ganqrr-crypto/STM32_devboard_STM32F411RET/CAD/STM32_Board.step

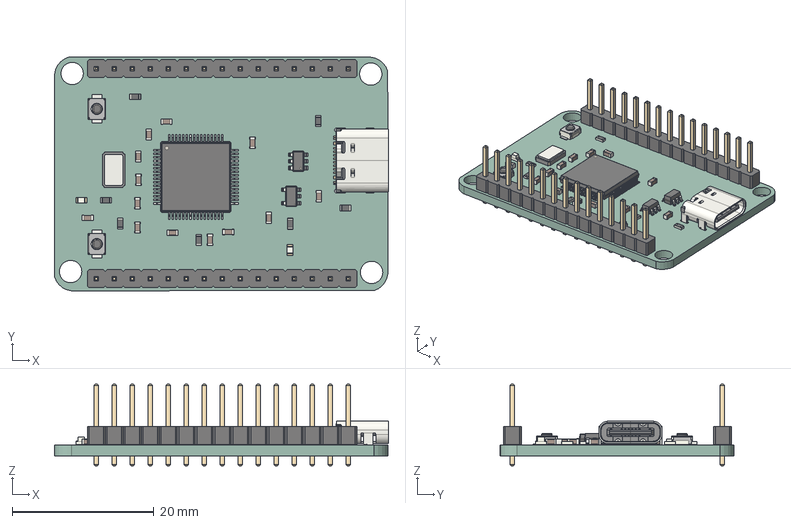
[picture p1: CAD file, 2026-11-06]
CAD/STM32_Board.step
47.2 x 33.0 x 11.5 mm
R_0603_1608Metric x 7
C_0603_1608Metric x 13
SOT-23-6
PinHeader_1x15_P254mm_Vertical x 2
LED_0603_1608Metric x 2
SW_SPST_B3U-1000P x 2
Crystal_SMD_Abracon_ABM3B-4Pin_5.0x3.2mm
SOT-23-5
LQFP-64_10x10mm_P0.5mm
USB_C_Receptacle_16P_TopMnt_Horizontal_GCT_USB4105-xx-A
STM1B8D_PCB
