ganqrr-crypto/STM32_devboard_STM32F411RET/PCB/STM32_Board.kicad_pcb

## KiCad design PCB/STM32_Board.kicad_pcb (2026-11-06)

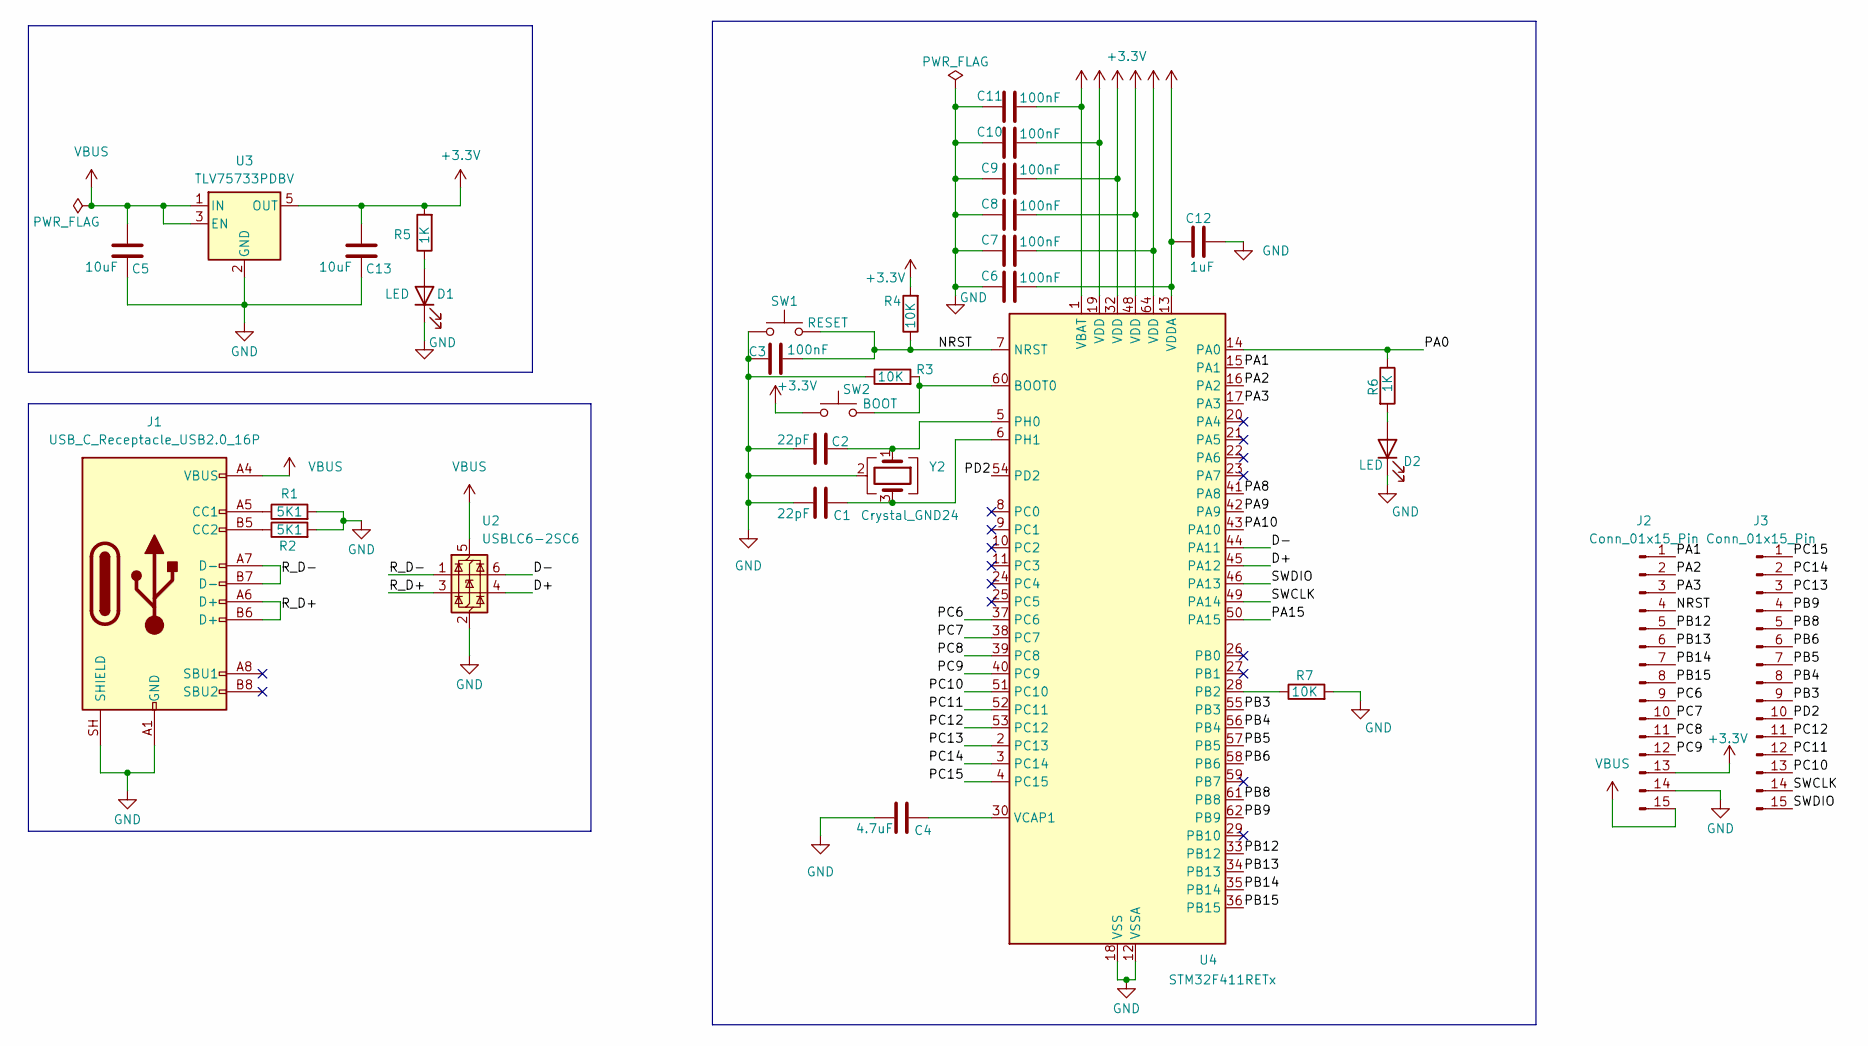
[picture p2: schematic STM32_Board.kicad_sch]

Parts:
C1, C2: 22pF; C_0603_1608Metric_Pad1.08x0.95mm_HandSolder
C3, C6, C7, C8, C9, C10, C11: 100nF; C_0603_1608Metric_Pad1.08x0.95mm_HandSolder
C4: 4.7uF; C_0603_1608Metric_Pad1.08x0.95mm_HandSolder
C5, C13: 10uF; C_0603_1608Metric_Pad1.08x0.95mm_HandSolder
C12: 1uF; C_0603_1608Metric_Pad1.08x0.95mm_HandSolder
D1, D2: LED; LED_0603_1608Metric_Pad1.05x0.95mm_HandSolder
J1: USB_C_Receptacle_USB2.0_16P; USB_C_Receptacle_GCT_USB4105-xx-A_16P_TopMnt_Horizontal
J2, J3: Conn_01x15_Pin; PinHeader_1x15_P2.54mm_Vertical
R1, R2: 5K1; R_0603_1608Metric_Pad0.98x0.95mm_HandSolder
R3, R4, R7: 10K; R_0603_1608Metric_Pad0.98x0.95mm_HandSolder
R5, R6: 1K; R_0603_1608Metric_Pad0.98x0.95mm_HandSolder
SW1: RESET; SW_SPST_B3U-1000P
SW2: BOOT; SW_SPST_B3U-1000P
U2: USBLC6-2SC6; SOT-23-6
U3: TLV75733PDBV; SOT-23-5
U4: STM32F411RETx; LQFP-64_10x10mm_P0.5mm
Y2: Crystal_GND24; Crystal_SMD_Abracon_ABM3B-4Pin_5.0x3.2mm

Connections:
+3.3V: C6.2, C7.2, C8.2, C9.2, C10.2, C11.2, C12.2, C13.1, J2.13, R4.2, R5.2, SW2.1, U3.5 (OUT), U4.1 (VBAT), U4.13 (VDDA), U4.19 (VDD), U4.32 (VDD), U4.48 (VDD), U4.64 (VDD); also elsewhere on the board
/D+: U2.4 (I/O2), U4.45 (PA12)
/D-: U2.6 (I/O1), U4.44 (PA11)
/NRST: C3.2, J2.4, R4.1, SW1.2, U4.7 (NRST); also elsewhere on the board
/PA0: R6.1, U4.14 (PA0)
/PA1: J2.1, U4.15 (PA1)
/PA2: J2.2, U4.16 (PA2)
/PA3: J2.3, U4.17 (PA3)
/PA8: U4.41 (PA8)
/PA9: U4.42 (PA9)
/PA10: U4.43 (PA10)
/PA15: U4.50 (PA15)
/PB3: J3.9, U4.55 (PB3)
/PB4: J3.8, U4.56 (PB4)
/PB5: J3.7, U4.57 (PB5)
/PB6: J3.6, U4.58 (PB6)
/PB8: J3.5, U4.61 (PB8)
/PB9: J3.4, U4.62 (PB9)
/PB12: J2.5, U4.33 (PB12)
/PB13: J2.6, U4.34 (PB13)
/PB14: J2.7, U4.35 (PB14)
/PB15: J2.8, U4.36 (PB15)
/PC6: J2.9, U4.37 (PC6)
/PC7: J2.10, U4.38 (PC7)
/PC8: J2.11, U4.39 (PC8)
/PC9: J2.12, U4.40 (PC9)
/PC10: J3.13, U4.51 (PC10)
/PC11: J3.12, U4.52 (PC11)
/PC12: J3.11, U4.53 (PC12)
/PC13: J3.3, U4.2 (PC13)
/PC14: J3.2, U4.3 (PC14)
/PC15: J3.1, U4.4 (PC15)
/PD2: J3.10, U4.54 (PD2)
/R_D+: J1.A6 (D+), J1.B6 (D+), U2.3 (I/O2)
/R_D-: J1.A7 (D-), J1.B7 (D-), U2.1 (I/O1)
/SWCLK: J3.14, U4.49 (PA14)
/SWDIO: J3.15, U4.46 (PA13)
GND: C1.1, C2.1, C3.1, C4.1, C5.2, C6.1, C7.1, C8.1, C9.1, C10.1, C11.1, C12.1, C13.2, D1.1 (K), D2.1 (K), J1.A1 (GND), J1.A12 (GND), J1.B1 (GND), J1.B12 (GND), J1.SH (SHIELD), J2.14, R1.2, R2.2, R3.1, R7.2, SW1.1, U2.2 (GND), U3.2 (GND), U4.12 (VSSA), U4.18 (VSS), U4.31 (VSS), U4.47 (VSS), U4.63 (VSS), Y2.2 (G), Y2.4 (G); also elsewhere on the board
unnamed: D1.2 (A), R5.1
unnamed: D2.2 (A), R6.2
unnamed: J1.A5 (CC1), R1.1
unnamed: J1.B5 (CC2), R2.1
unnamed 42: R3.2, SW2.2, U4.60 (BOOT0); also elsewhere on the board
unnamed: R7.1, U4.28 (PB2)
unnamed: C2.2, U4.5 (PH0), Y2.1
unnamed: C1.2, U4.6 (PH1), Y2.3
unnamed: C4.2, U4.30 (VCAP1)
VBUS: C5.1, J1.A4 (VBUS), J1.A9 (VBUS), J1.B4 (VBUS), J1.B9 (VBUS), J2.15, U2.5 (VBUS), U3.1 (IN), U3.3 (EN)

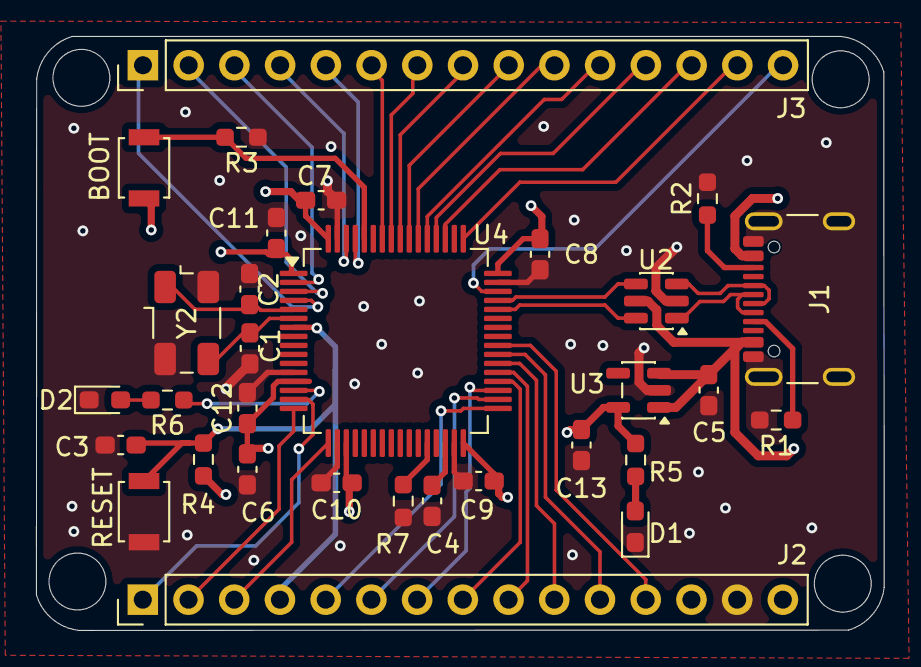
[picture p3: board STM32_Board.kicad_pcb from above]

Board: 4 copper layers, 47.1 x 33.0 mm, 31 parts (0 on the bottom side), 44 nets.

Other parts of the board:
BOOT: BOOT; SW_SPST_B3U-1000P
RESET: RESET; SW_SPST_B3U-1000P

Their connections:
+3.3V: BOOT.1; also elsewhere on the board
/NRST: RESET.2; also elsewhere on the board
GND: RESET.1; also elsewhere on the board
unnamed 42: BOOT.2; also elsewhere on the board
