ganqrr-crypto/STM32_devboard_STM32F411RET/JOURNAL.md

---
title: "STM32 Board"
github: "https://github.com/ganqrr-crypto/STM32_devboard_STM32F411RET"
description: "It's my first 4 layer board and i am building it to see how STM works"
created_at: "2026-11-01"
total_time: "12h 30m"
---

# November 1, 2026: Research and schematics
<!-- fabricate:entry 1813 -->

I started working on the schematics but betfore i did some research. ST datasheets are very wierd but i took a look at other projects who used this chip and this is the STM32F446RET6 i saw it's pretty cool...
then started working on the schematics and im planning on how to do the 4 layer



**Total time spent: 1h**

# November 2, 2026: Finished schematcis
<!-- fabricate:entry 1862 -->

I kinda finished the schematics. The thing is i don't know if they're right i still need to check them and see with other people who worked with this chip. i added the LDO and a builtin led and finished wiring the 8mhz crystal checking the datasheets of the chip.



**Total time spent: 1h 30m**

# November 2, 2026 (entry 2): More work on the schematics
<!-- fabricate:entry 2054 -->

So i worked a bit more on the schematics and i achieved pretty much what i wanted but i did some important changes. i changed the STM32 chip to a similar one because the one i chose wasnt on stock on TME so i chose another one. the old one was the F446 and the new one is F441 that i am using. they are similar but i decided to add the BOOT button so worst case scenario ill have a backup, the rest is still the same i did some adjustments, changed the cap on VCAP to 4.7uF 

and that's it.

**Total time spent: 36m**

# November 3, 2026: Routed a part of the PCB
<!-- fabricate:entry 2096 -->

i started routing most of the PCB after applying the footprints i started with the layout :


then i started routing and i made some adjustments


i started using the 3rd layer for power and the back copper for the gpios that wont fit on the front layer.


this is the pcb now


**Total time spent: 3h**

# November 3, 2026 (entry 2): More routing
<!-- fabricate:entry 2101 -->

i finished routing the GPIOS and i cleared all the DRC erros. like clearance, connections, ground planes etc. now i just need to make a good checkup if the board has nothing wrong.





**Total time spent: 24m**

# November 5, 2026: Re routed the PCB
<!-- fabricate:entry 2209 -->

I fully rerouted the PCB i still need to inspect it but looks way better. i added some clearance to the crystal, fixed the wierd rounded corner, added 5V, GND and 3.3 rail on headers, added SWDIO on header and a bit more fixes.

Here i deleted all the traces and vias:



Here i routed the power traces


And this is where i am now: 





The schematics didn't change much but i guess they're fine:


**Total time spent: 2h 30m**

# November 6, 2026: Inspections
<!-- fabricate:entry 2265 -->

i did some inspections to see if i missed something but everything seems right to me.. doing it maybe again this evening and then ill build the rest for the submit. this will be the last tier 4 until ill raise the bar to tier 3. the schemaitcs didn't save so i had to redo the latest changes but thats fine as i still had the pcb




**Total time spent: 42m**

# November 6, 2026 (entry 2): Improvements and made BOM
<!-- fabricate:entry 2270 -->

I improved the crystal routing and placement by making the routes shorter and hopefully it is better and then i made the BOM of the parts i need and pretty much i found them all.






**Total time spent: 1h 30m**

# November 6, 2026 (entry 3): Done
<!-- fabricate:entry 2277 -->

I am done building the PCB. And setting up things.. I am not very confident about this so i expect to be sent back but we'll see. here is the work i did now i set up all the github project


then while setting it up i realised my pcb didn't have silkscreen for the pins so i added silkscreen indicators on the back


also i made some simple code and gave it a final look. Looks fine to me but going to see if it's good or no soon..

**Total time spent: 1h**

# November 9, 2026: Fixed the readme
<!-- fabricate:entry 2490 -->

I fixed the readme because it was too simple and yeah i agree. I started writing about where to find the gerbers what caps size is used more pictures and more information and i moved the BOM to the bottom.



**Total time spent: 18m**
