ganqrr-crypto/STM32_devboard_STM32F411RET/(commit log)

2026-11-06 Added PCB files
    [STM32_Board.kicad_pcb, STM32_Board.kicad_sch]
2026-11-06 Update README with BOM and PCB images
    Added a bill of materials (BOM) with components and costs, along with PCB images.
2026-11-06 Crystal and BOM and gerbers update
    [BOM.csv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]
2026-11-06 Added pcb step
    [STM32_Board.step]
2026-11-06 Add project journal for STM32 board development
    Document detailed progress on the STM32 board project, including research, schematic completion, PCB routing, inspections, and improvements.
2026-11-06 Updated gerbers and pcb
    [STM32_Board-B_Cu.gbr, STM32_Board-B_Mask.gbr, STM32_Board-B_Paste.gbr, STM32_Board-B_Silkscreen.gbr, STM32_Board-Edge_Cuts.gbr, STM32_Board-F_Cu.gbr, STM32_Board-F_Mask.gbr, STM32_Board-F_Paste.gbr]
2026-11-09 Update README with project details and images
    Expanded project details including features, BOM, and images.
2026-11-09 Update README with gerbers and CAD model details
    Added information about gerbers and 3D STEP model location.
2026-11-09 Update total time and add readme fix entry
    Updated total time spent on the STM32 board project and added a new entry about fixing the readme with more details.
2026-11-10 Enhance README with project details and BOM
    Added features, NRST button notes, important folder locations, and BOM details to README.
